willplatts/xmas-tree/README.md

# xmas-tree
PCB Xmas tree decoration

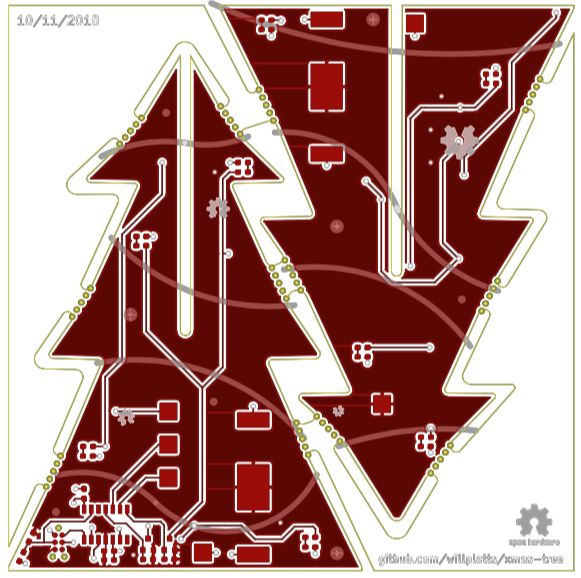
[picture p1: images/top.png]
Top

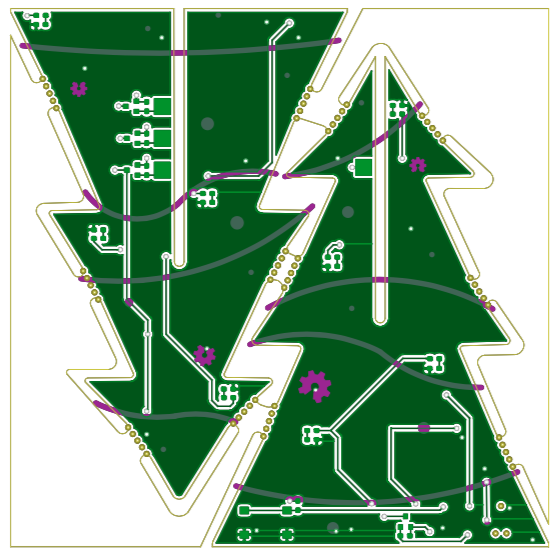
[picture p2: images/bottom.png]
Bottom
