willplatts/xmas-tree/PCB/singletree.png

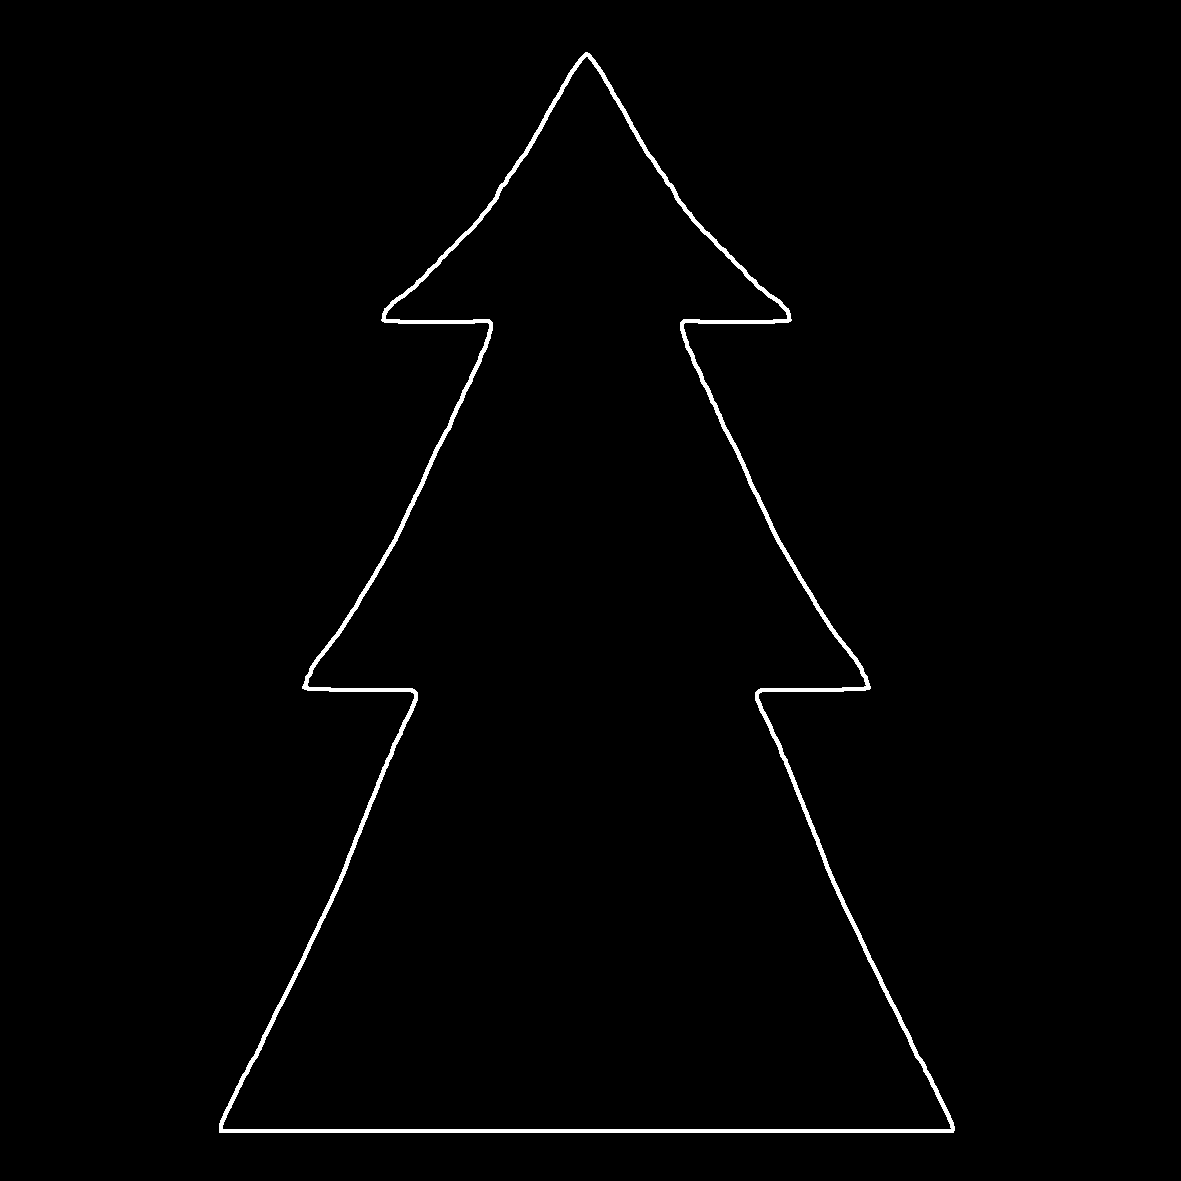
PCB/singletree.png
