willplatts/xmas-tree/PCB/xmas_tree.kicad_pcb

## KiCad design PCB/xmas_tree.kicad_pcb (2018-11-11)

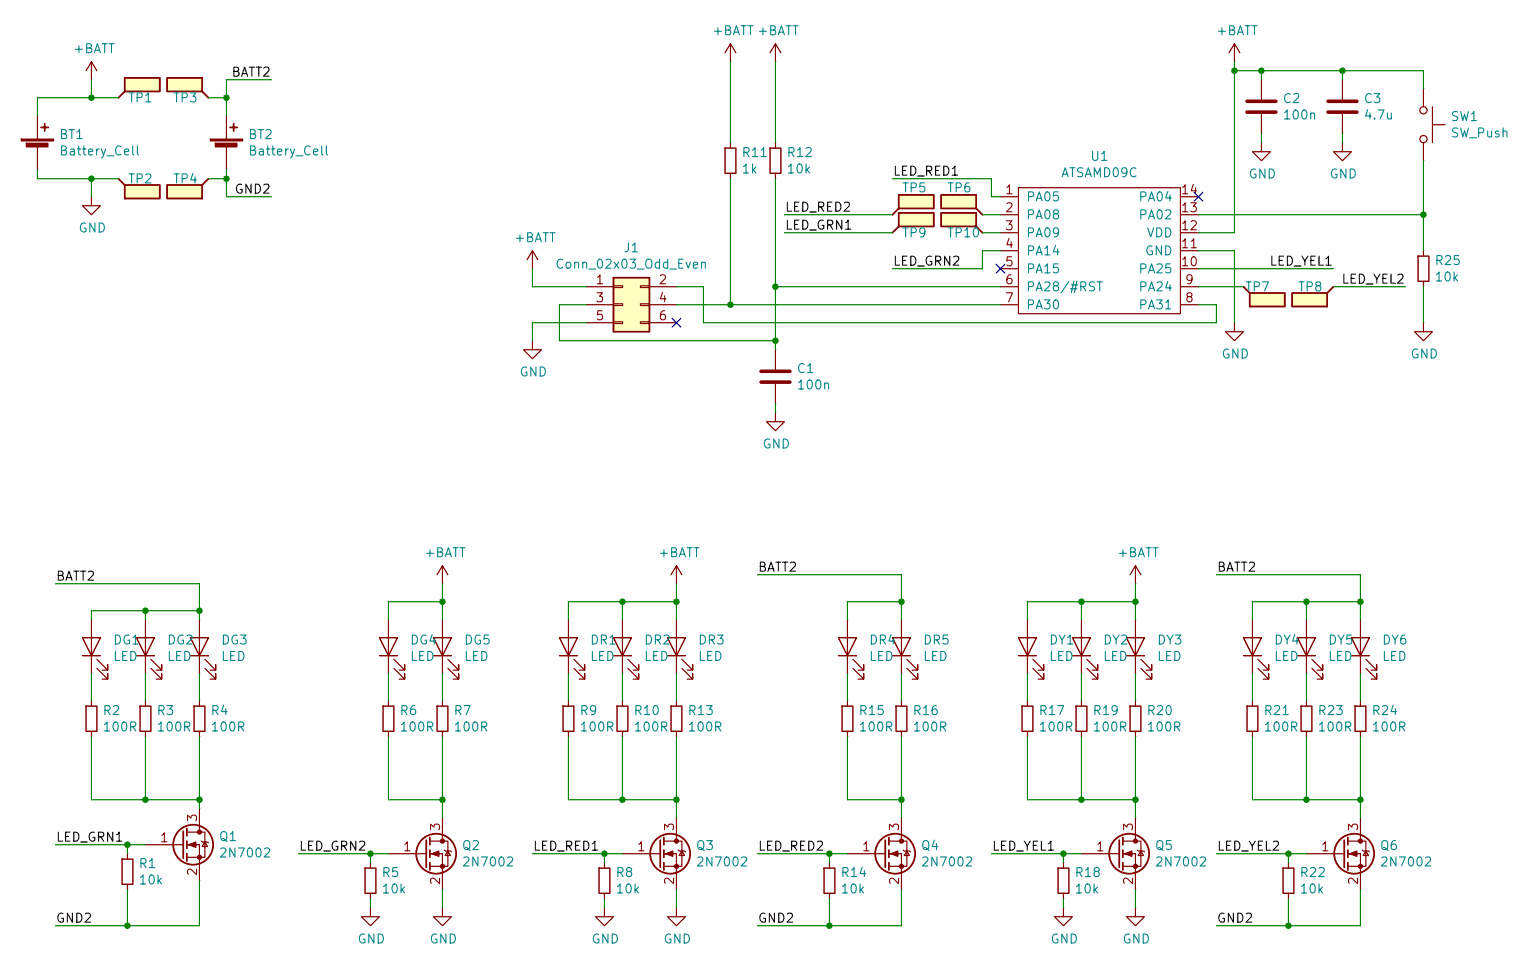
[picture p4: schematic xmas_tree.sch, Xmas Tree]

Parts:
BT1, BT2: Battery_Cell; BatteryHolder_MPD_BC2003_1x2032
C1, C2: 100n; C_0603_1608Metric_Pad1.05x0.95mm_HandSolder
C3: 4.7u; LED_0603_1608Metric_Pad1.05x0.95mm_HandSolder
DG1, DG2, DG3, DG4, DG5: LED; LED_0603_1608Metric_Pad1.05x0.95mm_HandSolder
DR1, DR2, DR3, DR4, DR5: LED; LED_0603_1608Metric_Pad1.05x0.95mm_HandSolder
DY1, DY2, DY3, DY4, DY5, DY6: LED; LED_0603_1608Metric_Pad1.05x0.95mm_HandSolder
J1: Conn_02x03_Odd_Even; Tag-Connect_TC2030-IDC-NL_2x03_P1.27mm_Vertical
Q1, Q2, Q3, Q4, Q5, Q6: 2N7002; SOT-23
R1, R5, R8, R12, R14, R18, R22, R25: 10k; R_0603_1608Metric_Pad1.05x0.95mm_HandSolder
R2, R3, R4, R6, R7, R9, R10, R13, R15, R16, R17, R19, R20, R21, R23, R24: 100R; R_0603_1608Metric_Pad1.05x0.95mm_HandSolder
R11: 1k; R_0603_1608Metric_Pad1.05x0.95mm_HandSolder
SW1: SW_Push; SW_SPST_B3S-1000
TP1, TP2, TP3, TP4, TP5, TP6, TP7, TP8, TP9, TP10: TestPoint_Flag; TestPoint_Pad_3.0x3.0mm
U1: ATSAMD09C; SOIC-14_3.9x8.7mm_P1.27mm

Connections:
+BATT: BT1.1 (+), C2.1, C3.1, DG4.2 (A), DG5.2 (A), DR1.2 (A), DR2.2 (A), DR3.2 (A), DY1.2 (A), DY2.2 (A), DY3.2 (A), J1.1, R11.1, R12.1, SW1.1, TP1.1, U1.12 (VDD)
/BATT2: BT2.1 (+), DG1.2 (A), DG2.2 (A), DG3.2 (A), DR4.2 (A), DR5.2 (A), DY4.2 (A), DY5.2 (A), DY6.2 (A), TP3.1
/GND2: BT2.2 (-), Q1.2 (S), Q4.2 (S), Q6.2 (S), R1.2, R14.2, R22.2, TP4.1
/LED_GRN1: Q1.1 (G), R1.1, TP9.1
/LED_GRN2: Q2.1 (G), R5.1, U1.4 (PA14)
/LED_RED1: Q3.1 (G), R8.1, U1.1 (PA05)
/LED_RED2: Q4.1 (G), R14.1, TP5.1
/LED_YEL1: Q5.1 (G), R18.1, U1.10 (PA25)
/LED_YEL2: Q6.1 (G), R22.1, TP8.1
GND: BT1.2 (-), C1.2, C2.2, C3.2, J1.5, Q2.2 (S), Q3.2 (S), Q5.2 (S), R5.2, R8.2, R18.2, R25.2, TP2.1, U1.11 (GND)
unnamed: C1.1, J1.3, R12.2, U1.6 (PA28/#RST)
unnamed: DG1.1 (K), R2.1
unnamed: DG2.1 (K), R3.1
unnamed: DG3.1 (K), R4.1
unnamed: DG4.1 (K), R6.1
unnamed: DG5.1 (K), R7.1
unnamed: DR1.1 (K), R9.1
unnamed: DR2.1 (K), R10.1
unnamed: DR3.1 (K), R13.1
unnamed: DR4.1 (K), R15.1
unnamed: DR5.1 (K), R16.1
unnamed: DY1.1 (K), R17.1
unnamed: DY2.1 (K), R19.1
unnamed: DY3.1 (K), R20.1
unnamed: DY4.1 (K), R21.1
unnamed: DY5.1 (K), R23.1
unnamed: DY6.1 (K), R24.1
unnamed: J1.2, U1.8 (PA31)
unnamed: J1.4, R11.2, U1.7 (PA30)
unnamed: Q1.3 (D), R2.2, R3.2, R4.2
unnamed: Q2.3 (D), R6.2, R7.2
unnamed: Q3.3 (D), R9.2, R10.2, R13.2
unnamed: Q4.3 (D), R15.2, R16.2
unnamed: Q5.3 (D), R17.2, R19.2, R20.2
unnamed: Q6.3 (D), R21.2, R23.2, R24.2
unnamed: R25.1, SW1.2, U1.13 (PA02)
unnamed: TP6.1, U1.2 (PA08)
unnamed: TP7.1, U1.9 (PA24)
unnamed: TP10.1, U1.3 (PA09)

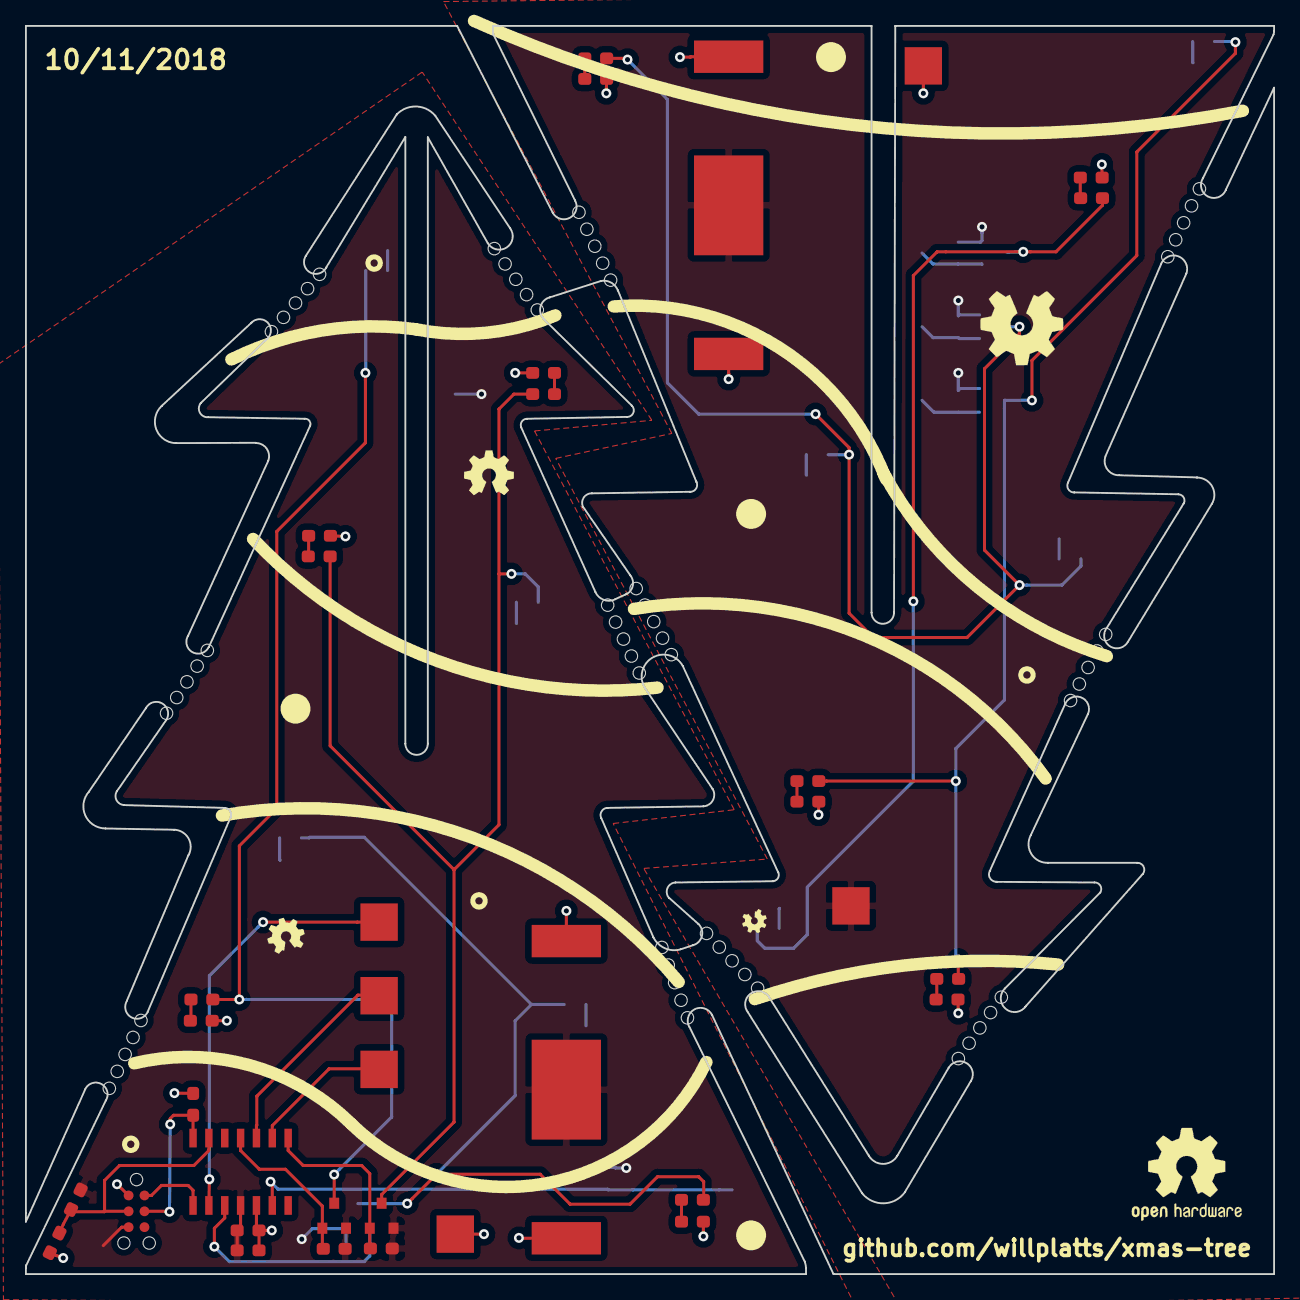
[picture p5: board xmas_tree.kicad_pcb from above]

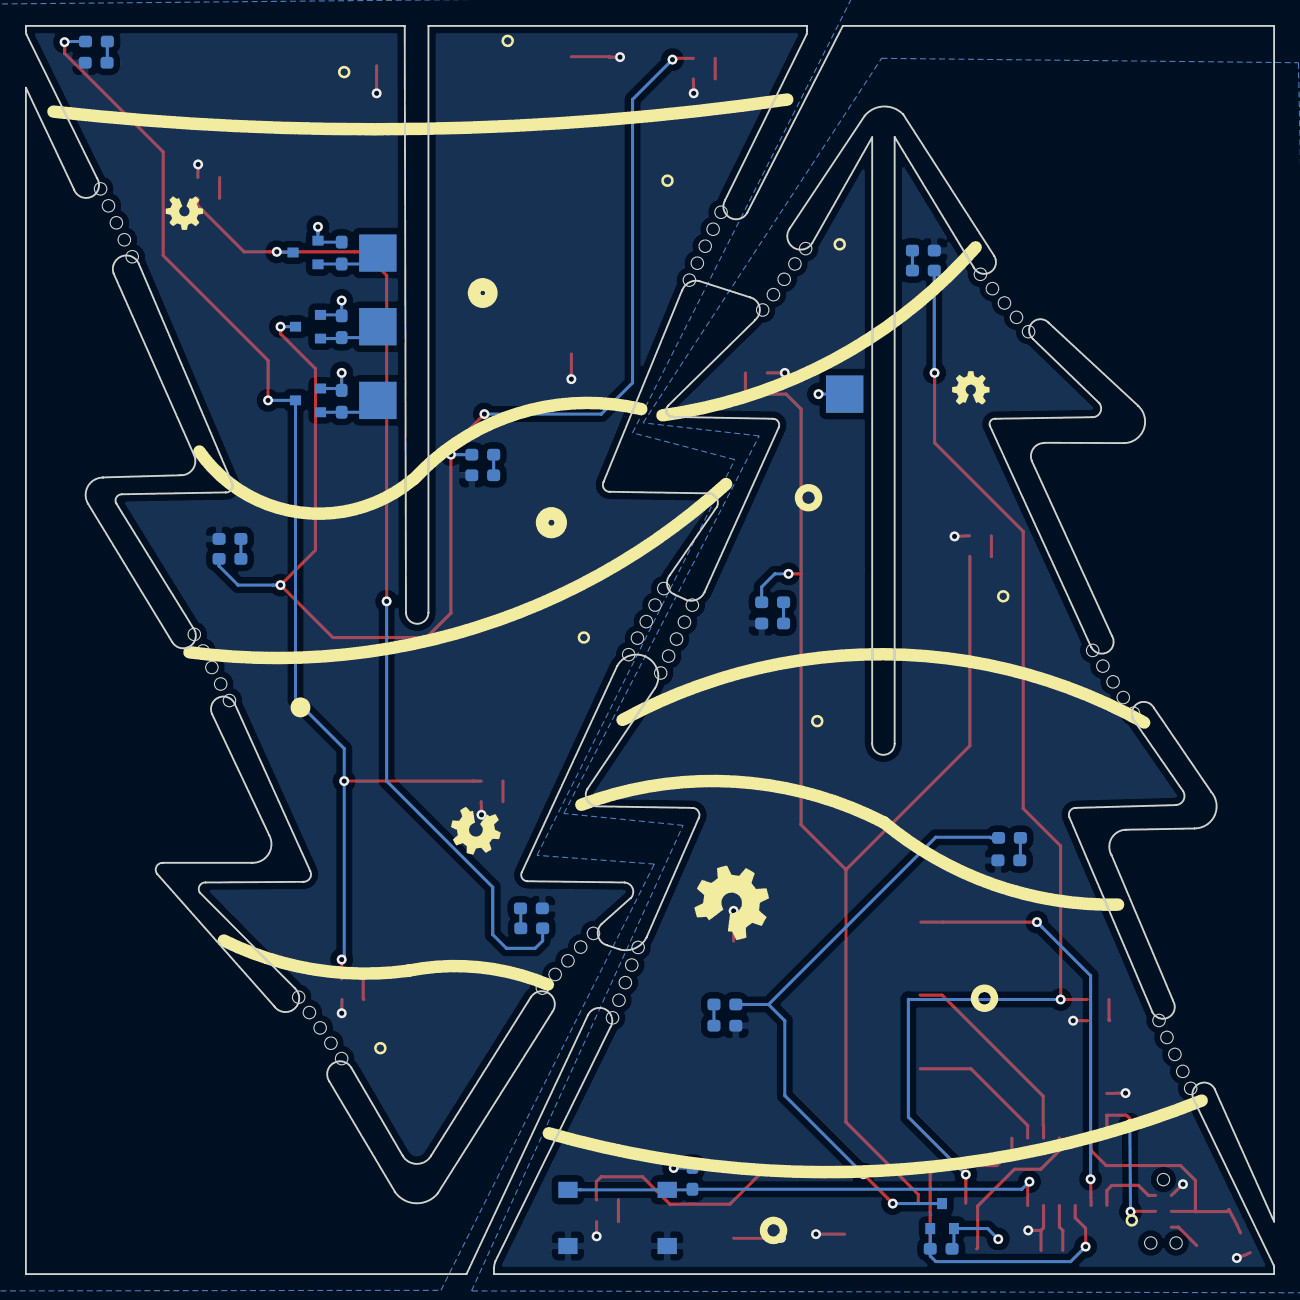
[picture p6: board xmas_tree.kicad_pcb from below]

Board: 2 copper layers, 100.0 x 100.0 mm, 65 parts (30 on the bottom side), 39 nets.
