willplatts/xmas-tree/SW/xmastree.h

#ifndef XMASTREE_H__
#define XMASTREE_H__

constexpr uint32_t PIN_GRN1 = 9u;
constexpr uint32_t PIN_GRN2 = 14u;
constexpr uint32_t PIN_RED1 = 5u;
constexpr uint32_t PIN_RED2 = 8u;
constexpr uint32_t PIN_YEL1 = 25u;
constexpr uint32_t PIN_YEL2 = 24u;

constexpr uint32_t MASK_GRN1_SET = (1u << PIN_GRN1);
constexpr uint32_t MASK_GRN2_SET = (1u << PIN_GRN2);
constexpr uint32_t MASK_RED1_SET = (1u << PIN_RED1);
constexpr uint32_t MASK_RED2_SET = (1u << PIN_RED2);
constexpr uint32_t MASK_YEL1_SET = (1u << PIN_YEL1);
constexpr uint32_t MASK_YEL2_SET = (1u << PIN_YEL2);

#endif /* XMASTREE_H__ */
