willplatts/xmas-tree/(commit log)

2018-11-11 Adding version 1.0 xmas tree.
    [xmas_tree.kicad_pcb, xmas_tree.sch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]
2018-11-11 Adding exported PCB images
2018-12-20 Moving PCB files into subdirectory and adding software directory
    [xmas_tree.kicad_pcb, xmas_tree.sch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]
2018-12-20 Removing timer
